akueckes/newtech-model-6-music-board-replica/kicad_files/Newtech_Model_6_Music_Board/Newtech_Model_6_Music_Board.kicad_pcb

## KiCad design kicad_files/Newtech_Model_6_Music_Board/Newtech_Model_6_Music_Board.kicad_pcb (2026-11-10)

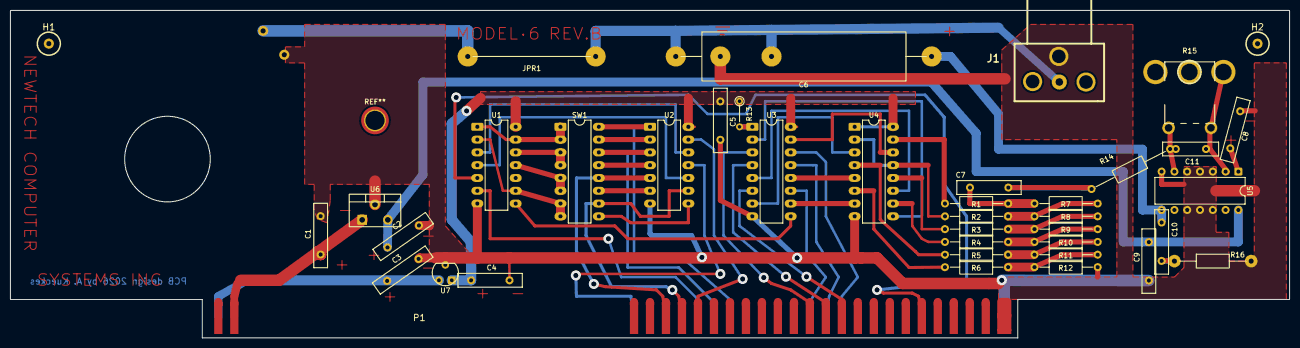
[picture p1: board Newtech_Model_6_Music_Board.kicad_pcb from above]

Board: 2 copper layers, 254.0 x 65.0 mm, 41 parts (0 on the bottom side), 56 nets.

Parts:
C1, C2, C3: 1uF; C_Disc_D10.0mm_W2.5mm_P300mil
C4, C5, C9, C10: .1; C_Disc_D10.0mm_W2.5mm_P300mil
C6: 220; C_Axial_L22.0mm_D9.5mm_P27.50mm_Horizontal
C7: .1; C_Disc_D10.0mm_W2.5mm_P5.00mm
C8: 4.7; C_Disc_D10.0mm_W2.5mm_P300mil
C11: .0022; C_Disc_D10.0mm_W2.5mm_P6.0mm
H1, H2, H3: Ejector; s100-ejector
J1: RCA_audio_jack
JPR1: R_Axial_DIN0207_L6.3mm_D2.5mm_P15.24mm_Horizontal
P1: S100_MALE
R1, R2, R3, R4, R5, R6: 20K; R_Axial_DIN0207_L6.3mm_D2.5mm_P12.70mm_Horizontal
R7, R8, R9, R10, R11, R12: 10K; R_Axial_DIN0207_L6.3mm_D2.5mm_P12.70mm_Horizontal
R13: 4.7K; R_Axial_DIN0204_L3.6mm_D1.6mm_P5.08mm_Vertical
R14: 2M; R_Axial_DIN0207_L6.3mm_D2.5mm_P15.24mm_Horizontal
R15: 25K; Bourns_3355
R16: 1; R_Axial_DIN0207_L6.3mm_D2.5mm_P15.24mm_Horizontal
SW1: SW_DIP_x08; CERDIP-16_W7.62mm_SideBrazed_LongPads
U1: 74LS30; DIP-14_W7.62mm_LongPads
U2: 74LS04; DIP-14_W7.62mm_LongPads
U3: 74LS174; CERDIP-16_W7.62mm_SideBrazed_LongPads
U4: 4050; CERDIP-16_W7.62mm_SideBrazed_LongPads
U5: LM380N; DIP-14_W7.62mm
U6: LM7812_TO220; TO-220-3_Vertical
U7: L78L05_TO92; TO-92_Inline

Connections:
+8V: C3.1, P1.1 (+8_V), P1.51 (+8_V), U7.3 (VI)
+12V: C2.1, C9.1, U5.14 (VS), U6.3 (VO)
+16V: C1.1, P1.2 (+16_V), U6.1 (VI)
/I/O Enable: U1.8, U3.9 (Cp)
A2: P1.81 (A2), U1.6
A3: P1.31 (A3), U2.13
A4: P1.30 (A4), SW1.10, U2.9
A5: P1.29 (A5), SW1.12, U2.5
A6: P1.82 (A6), SW1.14, U2.3
A7: P1.83 (A7), SW1.16, U2.1
DO2: P1.88 (DO2_ED2), U3.11 (D3)
DO3: P1.89 (DO3_ED3), U3.13 (D4)
DO4: P1.38 (DO4_ED4), U3.3 (D0)
DO5: P1.39 (DO5_ED5), U3.4 (D1)
DO6: P1.40 (DO6_ED6), U3.6 (D2)
DO7: P1.90 (DO7_ED7), U3.14 (D5)
GND: C1.2, C2.2, C3.2, C4.2, C5.2, C8.2, C9.2, J1.2 (Ext), P1.50 (0_V2), P1.100 (0_V5), R12.1, R16.2, U1.7 (GND), U2.7 (GND), U3.8 (GND), U4.8 (VSS), U5.3 (GND), U5.4 (GND), U5.5 (GND), U5.7 (GND), U5.10 (GND), U5.11 (GND), U5.12 (GND), U6.2 (GND), U7.2 (GND)
unnamed: C7.1, R1.1, R7.2
unnamed: C7.2, R14.2
unnamed: C10.1, R16.1
unnamed: C6.1, C10.2, U5.8
unnamed: C6.2, J1.1 (In), JPR1.1 (A)
unnamed: R1.2, U4.15
unnamed: R2.1, R7.1, R8.2
unnamed: R2.2, U4.2
unnamed: R3.1, R8.1, R9.2
unnamed: R3.2, U4.12
unnamed: R4.2, U4.10
unnamed: R5.2, U4.4
unnamed: R6.2, U4.6
unnamed: R5.1, R10.1, R11.2
unnamed: R4.1, R9.1, R10.2
unnamed: R6.1, R11.1, R12.2
unnamed: SW1.1, SW1.2, U1.1, U1.13
unnamed: SW1.3, SW1.4, U1.12
unnamed: SW1.5, SW1.6, U1.11
unnamed: SW1.7, SW1.8, U1.2, U1.9
unnamed: SW1.9, U2.8
unnamed: SW1.11, U2.6
unnamed: SW1.13, U2.4
unnamed: SW1.15, U2.2
unnamed: U1.3, U2.12
unnamed: U1.4, U2.10
unnamed: U3.2 (Q0), U4.9
unnamed: U3.5 (Q1), U4.11
unnamed: U3.7 (Q2), U4.3
unnamed: U3.10 (Q3), U4.7
unnamed: U3.12 (Q4), U4.5
unnamed: U3.15 (Q5), U4.14
unnamed: R13.2, U3.1 (~Mr)
unnamed: C11.2, R15.1, R15.2, U5.2 (+)
unnamed: C11.1, R14.1, R15.3, U5.6 (-)
unnamed: C8.1, U5.1 (BYPASS)
PWR/: P1.77 (pWR*), U2.11
SOUT: P1.45 (sOUT), U1.5
VCC: C4.1, C5.1, R13.1, U1.14 (VCC), U2.14 (VCC), U3.16 (VCC), U4.1 (VCC), U4.16, U7.1 (VO)
