akueckes/newtech-model-6-music-board-replica/kicad_files/Newtech_LPF-1/Newtech_LPF-1.kicad_pcb

## KiCad design kicad_files/Newtech_LPF-1/Newtech_LPF-1.kicad_pcb (2026-11-10)

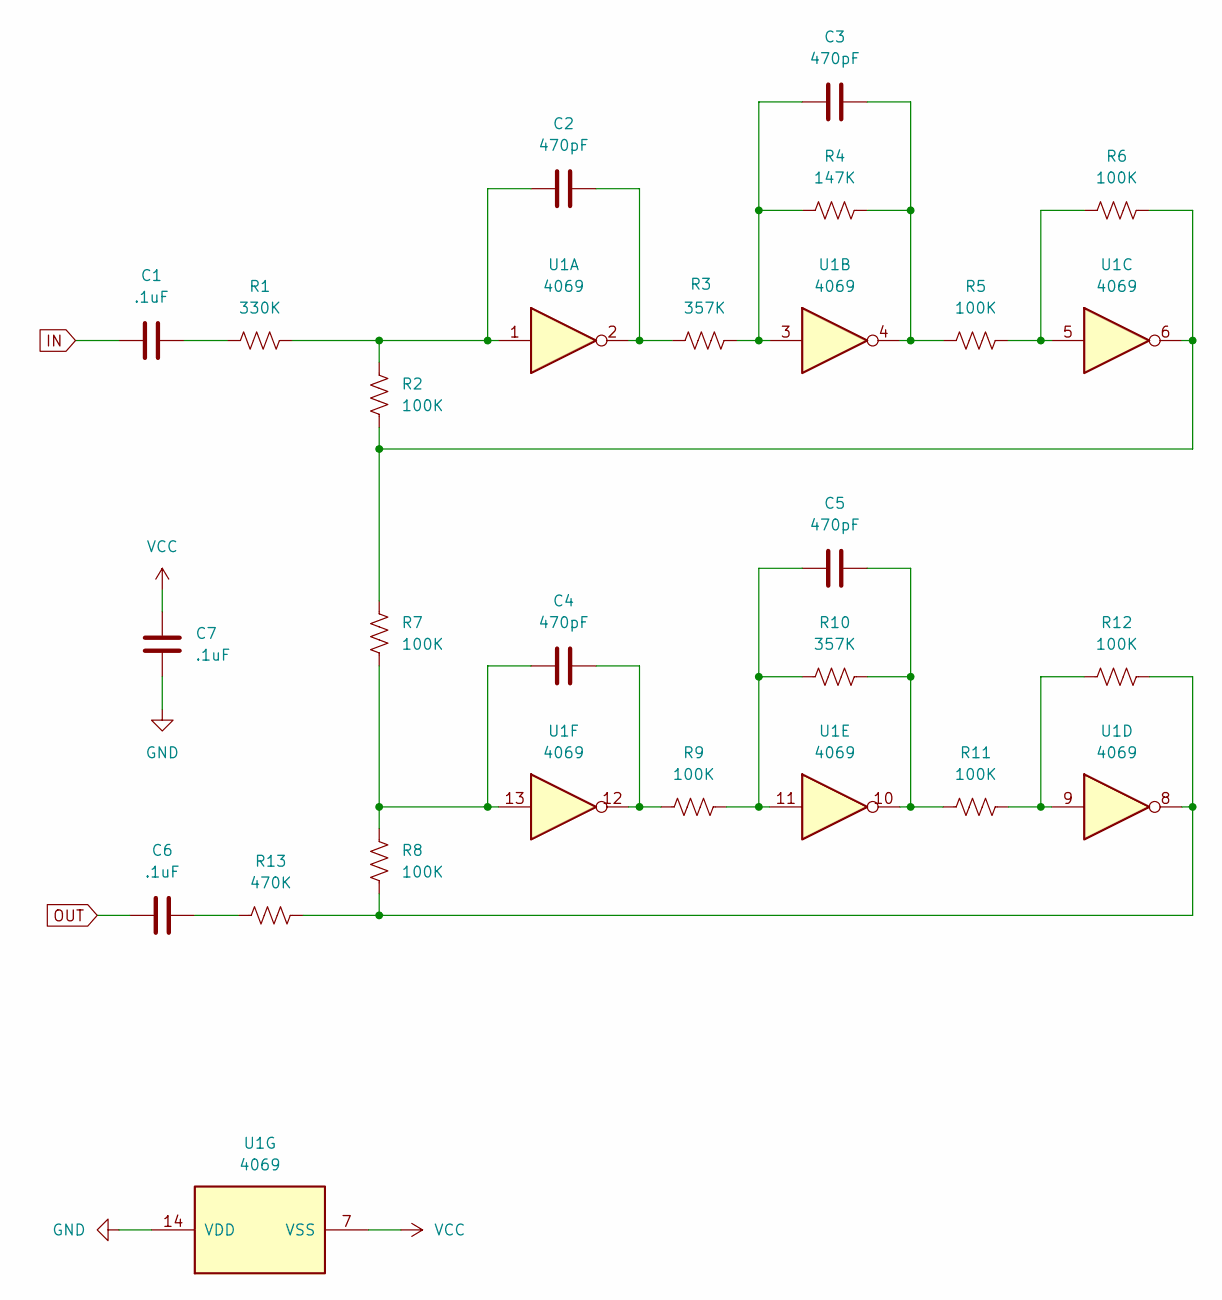
[picture p2: schematic Newtech_LPF-1.kicad_sch]

Parts:
C1, C6, C7: .1uF; C_Disc_D10.0mm_W2.5mm_P300mil
C2, C3, C4, C5: 470pF; C_Disc_D10.0mm_W2.5mm_P300mil
R1: 330K; R_Axial_2.5mm_500_mil
R2, R5, R6, R7, R8, R9, R11, R12: 100K; R_Axial_2.5mm_500_mil
R3, R10: 357K; R_Axial_2.5mm_500_mil
R4: 147K; R_Axial_2.5mm_500_mil
R13: 470K; R_Axial_2.5mm_500_mil
U1: 4069; DIP-14_W7.62mm_LongPads

Connections:
GND: C7.2, U1.14 (VDD)
IN: C1.1
unnamed: C1.2, R1.2
unnamed: C2.1, R1.1, R2.1, U1.1
unnamed: C2.2, R3.1, U1.2
unnamed: C3.1, R3.2, R4.1, U1.3
unnamed: C3.2, R4.2, R5.1, U1.4
unnamed: C4.1, R7.2, R8.1, U1.13
unnamed: C4.2, R9.1, U1.12
unnamed: C5.1, R9.2, R10.1, U1.11
unnamed: C5.2, R10.2, R11.1, U1.10
unnamed: C6.2, R13.1
unnamed: R2.2, R6.2, R7.1, U1.6
unnamed: R5.2, R6.1, U1.5
unnamed: R11.2, R12.1, U1.9
unnamed: R8.2, R12.2, R13.2, U1.8
OUT: C6.1
VCC: C7.1, U1.7 (VSS)

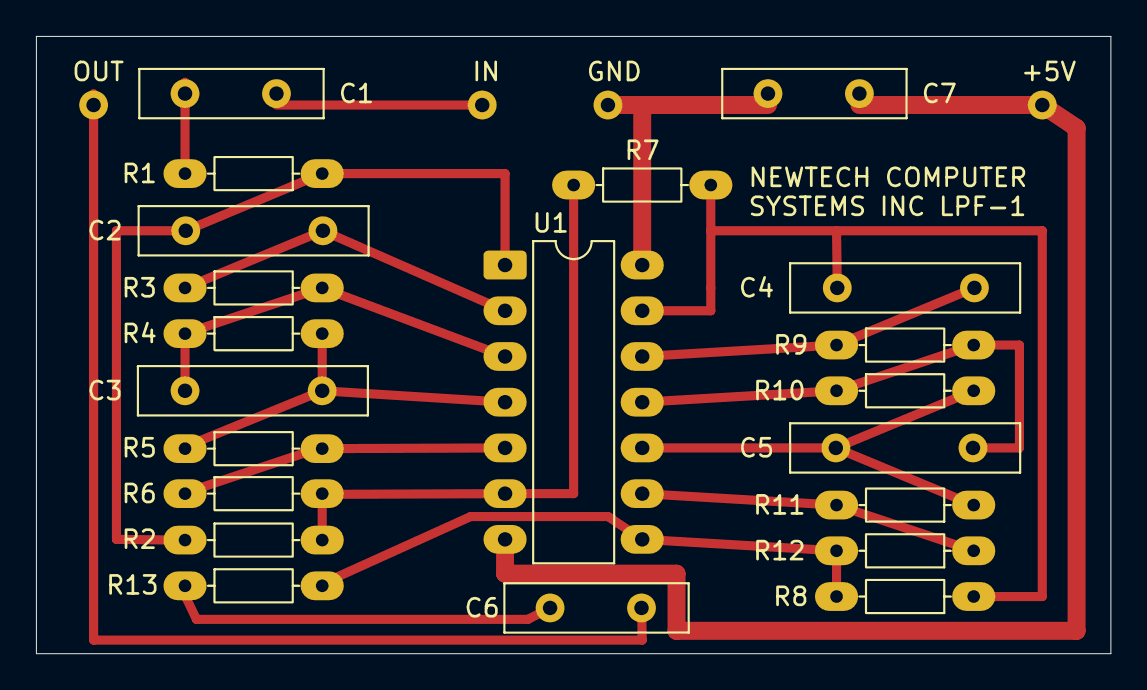
[picture p3: board Newtech_LPF-1.kicad_pcb from above]

Board: 2 copper layers, 59.7 x 34.3 mm, 21 parts (0 on the bottom side), 16 nets.
