akueckes/newtech-model-6-music-board-replica/(commit log)

2026-11-10 kicad, gerbers, manuals & audio test program
    [Newtech_LPF-1-B_Cu.gbr, Newtech_LPF-1-B_Mask.gbr, Newtech_LPF-1-B_Silkscreen.gbr, Newtech_LPF-1-Edge_Cuts.gbr, Newtech_LPF-1-F_Cu.gbr, Newtech_LPF-1-F_Mask.gbr, Newtech_LPF-1-F_Paste.gbr, Newtech_LPF-1-F_Silkscreen.gbr]
2026-11-10 music score sample file
